shiya-liu/claude-code-my-workflow/explorations/pomodoro-enclosure/README.md

# 番茄钟外壳 v2 · Slab

用于 Waveshare **ESP32-S3-Touch-LCD-3.5B** 的 3D 打印桌面外壳。
一块薄的圆角屏幕板（整块玻璃外露，外壳圆角和玻璃的 R6 圆角同心），以 15° 斜插在一个矮底座里。
电池、喇叭和线都藏在底座里。整台设备唯一的颜色是红色 PWR 键。

- 屏幕板：68 × 99.4 × 15 mm
- 底座：76 × 58 × 26 mm
- 整体高度约 111 mm

尺寸来自 Waveshare 官方尺寸图：玻璃 92.44 × 61.00（R6），显示区 73.44 × 48.96，总厚 11.50，
M2 铜柱孔距 72.00 × 48.50，按键间距 11.00 / 8.50 / 8.50。板子竖装，USB-C 朝下。

## 打印文件（`out/`）

文件已经按打印方向摆好，导入切片软件后**不需要旋转**。全部零件用**哑光黑 PLA**（PWR 键可选红色，没有红色就用黑色）。

| 文件 | 数量 | 说明 |
|---|---|---|
| `1_shell.stl` 屏幕板外框 | 1 | 正面贴床；最好用纹理 PEI 板，层高 0.12–0.16 |
| `2_foot.stl` 底座 | 1 | 顶面贴床（已倒置） |
| `3_plate.stl` 底板 | 1 | |
| `4_cover.stl` 背盖 | 1 | |
| `5_buttons.stl` 按键帽 | 1 套（2 个） | 法兰贴床；很小，建议和其他零件一起打 |

`out/print_bed.png` 是全部零件摆在一块 250 × 220 打印板上的示意（Prusa CORE One+ 一次能打完）。

用 PrusaSlicer 按下面的设置实际切片估算（CORE One+ 用速度相近的 MK4 Input Shaper 配置代替，属于偏保守的估计）：

| 打印机 | 5 个零件一起打 | 最长的单件（底座） | 耗材 |
|---|---|---|---|
| CORE One+（限时 4 小时） | 约 2 小时 10 分 | 约 1 小时 05 分 | 约 70 g |
| MINI+（限时 10 小时，180 × 180） | 约 5 小时 15 分 | 约 2 小时 35 分 | 约 70 g |

最大的零件 99 × 76 mm，两台打印机的尺寸都放得下。屏幕板外框改用 0.15 层高会多出约 7 分钟。

0.4 喷嘴，层高 0.2，3 圈墙，15% 填充，**不需要支撑**，不需要 brim。按这个设置约用 70 g PLA。

## 购物清单（淘宝 / 京东 / 拼多多搜索关键词）

| 零件 | 搜索关键词 | 说明 |
|---|---|---|
| 哑光黑 PLA 1kg | `哑光黑 PLA 1.75mm` | 拓竹、易生 eSUN、天瑞等都有 |
| 红色 PLA（少量） | `红色 PLA 1.75mm` 或买样品卷 | 只打一个按键帽，也可以黑色打印后涂红漆 |
| 锂电池 | `3.7V 聚合物锂电池 103450 MX1.25` | 单节，插头 MX1.25 两针；电池仓 62 × 46 × 11 mm |
| 90° 弯头 USB-C 充电线 | `Type-C 90度弯头 充电线` | 普通弯头线即可（线沿板子底边横着走的「侧弯」款也行），1 m 左右；线从底座背面的槽穿出，直接插充电头 |
| M2 沉头螺丝 × 4 | `M2x5 沉头 十字 机牙螺丝` | 背盖固定到板子背面的铜柱 |
| M2 沉头自攻螺丝 × 4 | `M2x6 沉头 自攻螺丝` | 底板固定到底座 |
| 硅胶脚垫 × 4 | `自粘 硅胶脚垫 10mm` | |
| 双面泡棉胶 | `双面泡棉胶 3M` | 固定电池和喇叭 |
| 小喇叭 | 先看板子包装里有没有；没有就搜 `8Ω 1W 小喇叭 MX1.25` | 买前对照板子上 SPK 插座的规格 |

### 在美国采购（Amazon 搜索关键词）

| 零件 | 搜索关键词 | 说明 |
|---|---|---|
| 哑光 PLA | `Polymaker Matte PLA` / `Bambu Lab PLA Matte` / `Elegoo Matte PLA` | 黑色选 Charcoal Black，白色选 Cotton White / Ivory White |
| 锂电池 | `3.7V lipo battery MX1.25 2 pin` | ⚠️ Adafruit 等美国常见锂电池多为 **JST-PH 2.0** 插头，插不进 MX1.25；需要买 MX1.25 的，或另买 `MX1.25 to JST PH adapter` |
| 90° 弯头 USB-C 充电线 | `USB C right angle charging cable` | 普通弯头线即可，1 m 左右 |
| M2 沉头螺丝 | `M2 flat head countersunk machine screw assortment` | 用 M2×5；精确规格也可在 McMaster-Carr 买 |
| M2 沉头自攻螺丝 | `M2 countersunk self tapping screws` | 用 M2×6 |
| 脚垫 | `self adhesive silicone bumper feet 10mm` | |
| 双面泡棉胶 | `3M double sided foam mounting tape` | |
| 小喇叭 | `8 ohm 1W mini speaker MX1.25` | 先看板子包装里有没有 |

美国在线打印服务：Craftcloud、JLC3DP（寄美国）、Xometry。

不想自己打印：把 STL 上传到嘉立创 3D 打印等在线服务，选黑色树脂或黑色尼龙。

## 组装顺序

1. 两个按键帽从屏幕板外框里面插进右侧两个圆孔（法兰在里面）。
2. 弯头 USB-C 插到板子底边的 USB-C 口（线朝左或朝右都可以），弯头会从屏幕板底部的开口露出一点，这是正常的。
3. 板子正面朝前放进外框，USB 口朝下、按键一侧朝右。
4. 盖上背盖，用 4 颗 M2×5 沉头螺丝拧进板子的 4 个铜柱。背盖两侧有摩擦筋，是压紧的；
   觉得松可以在边缘点几点热熔胶（以后还能剥掉）。USB 线和电池线从背盖底部的缺口出来。
5. 电池、喇叭放进底座的仓里（泡棉胶固定），喇叭对着背面的小孔。
6. 屏幕板插进底座斜槽：弯头落进斜槽下方的凹槽，充电线顺着电池仓走到背面，从背面底部的开口槽放出去（装底板前放进去，底板会把它压住）。接好电池线和喇叭线。
7. 装底板（4 颗 M2×6 自攻螺丝），贴脚垫。

## 注意

- **插电池前先对照板子上的 + 号核对红线**，不同商家 MX1.25 的线序可能相反。
- 板子竖装、USB 朝下，程序里的屏幕方向要设成对应的方向。
- **SD 卡槽的位置是从产品照片估算的**，打印前请量一下它离玻璃底边的距离，改 `sd_z`。
- 建议先打印屏幕板外框（`shell.stl`）试装，确认合适后再打其他件。
- 所有尺寸都在 `pomodoro_enclosure.scad` 顶部，可用 OpenSCAD 修改后重新导出：
  `openscad -D 'part="shell"' -o out/shell.stl pomodoro_enclosure.scad`
- v1（梯形斜角座）在 git 历史里，提交 `37cfcff`。
