shiya-liu/claude-code-my-workflow/explorations/pomodoro-enclosure/out/cmp_black_back.png

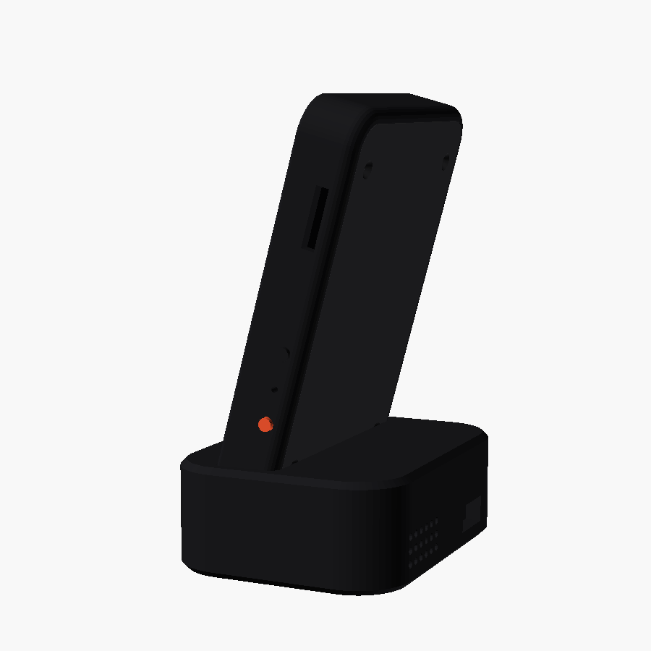
explorations/pomodoro-enclosure/out/cmp_black_back.png
