shiya-liu/claude-code-my-workflow/explorations/pomodoro-enclosure/out/cmp_black_front.png

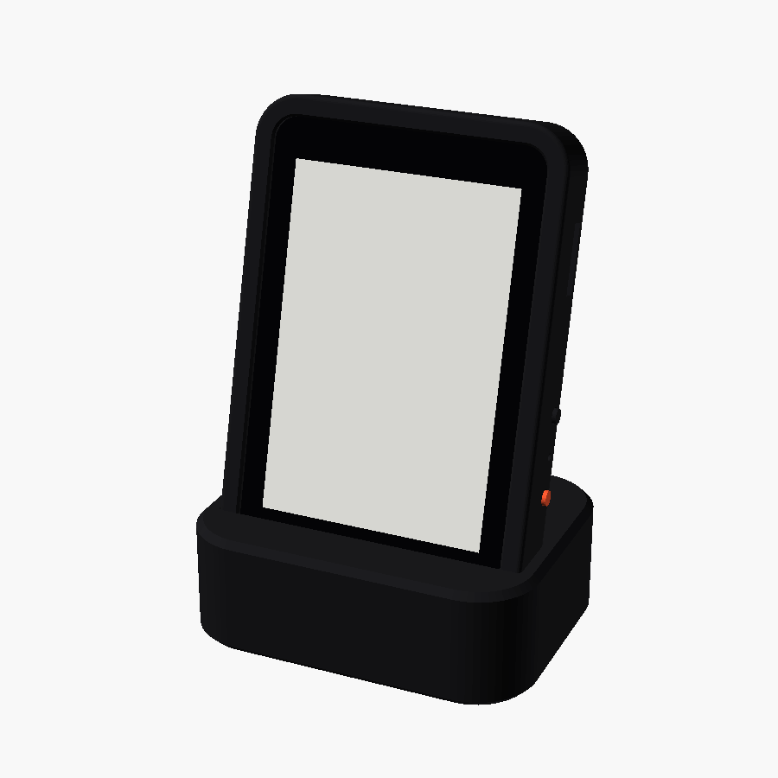
explorations/pomodoro-enclosure/out/cmp_black_front.png
