shiya-liu/claude-code-my-workflow/explorations/pomodoro-enclosure/out/cmp_white_front.png

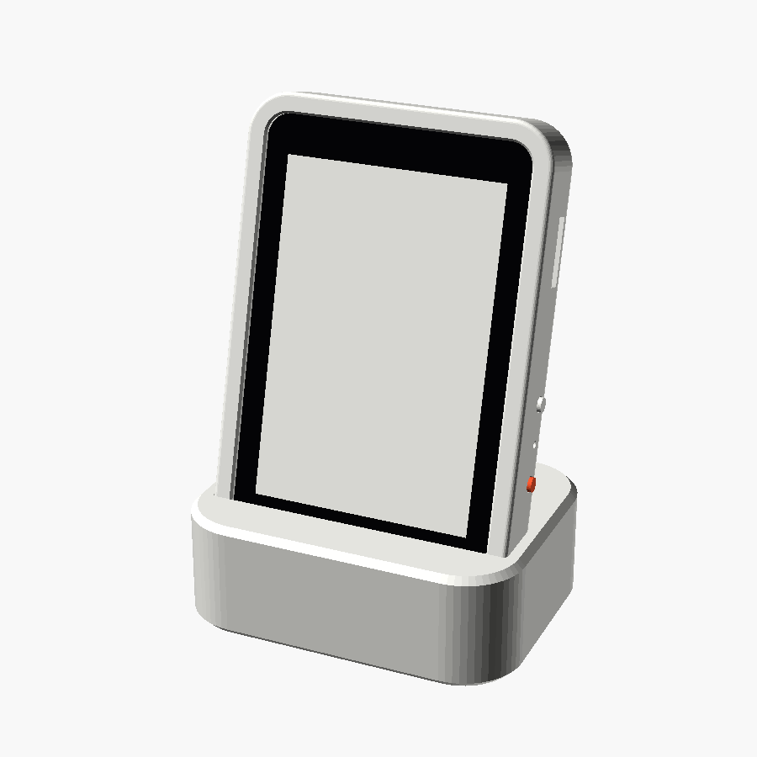
explorations/pomodoro-enclosure/out/cmp_white_front.png
