shiya-liu/claude-code-my-workflow/explorations/pomodoro-enclosure/out/compare_black_white.png

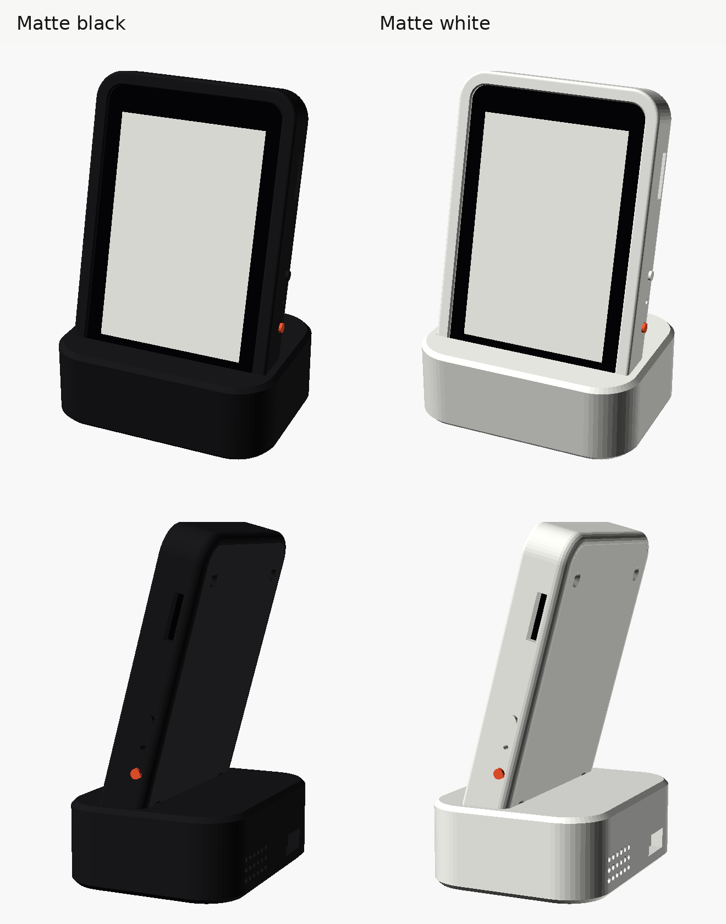
explorations/pomodoro-enclosure/out/compare_black_white.png
