shiya-liu/claude-code-my-workflow/explorations/pomodoro-enclosure/out/cutaway.png

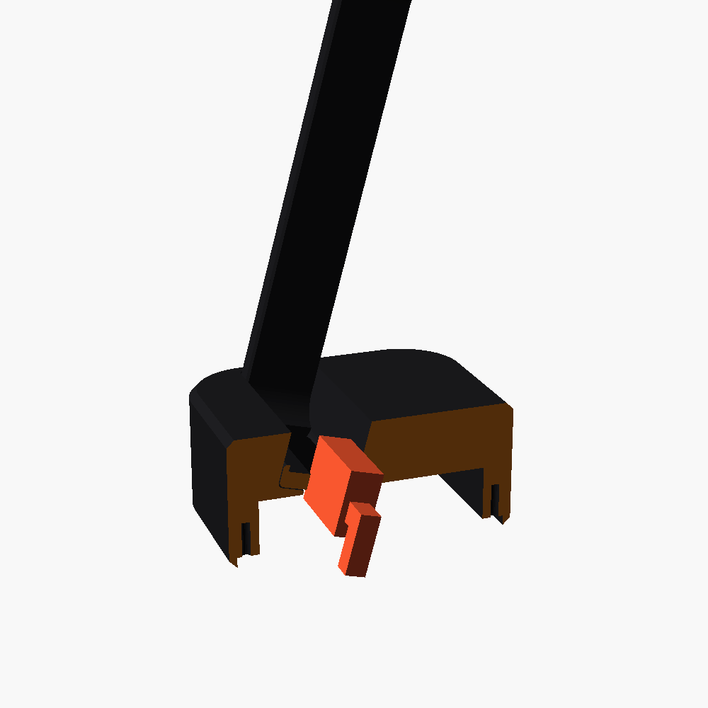
explorations/pomodoro-enclosure/out/cutaway.png
