shiya-liu/claude-code-my-workflow/explorations/pomodoro-enclosure/out/view_exploded.png

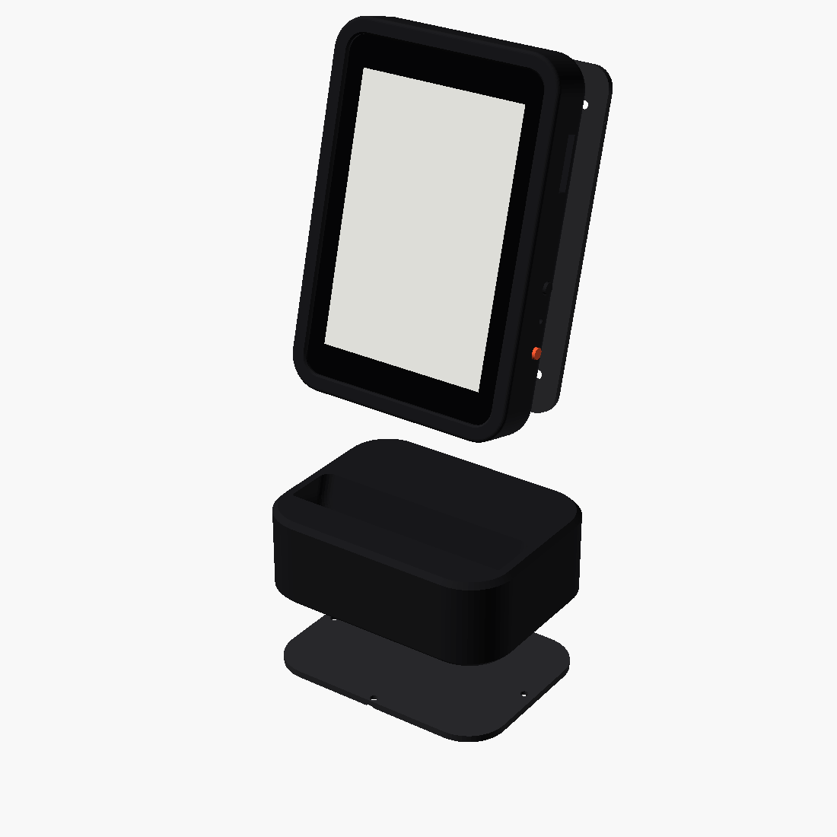
explorations/pomodoro-enclosure/out/view_exploded.png
