shiya-liu/claude-code-my-workflow/explorations/pomodoro-enclosure/out/4_cover.stl

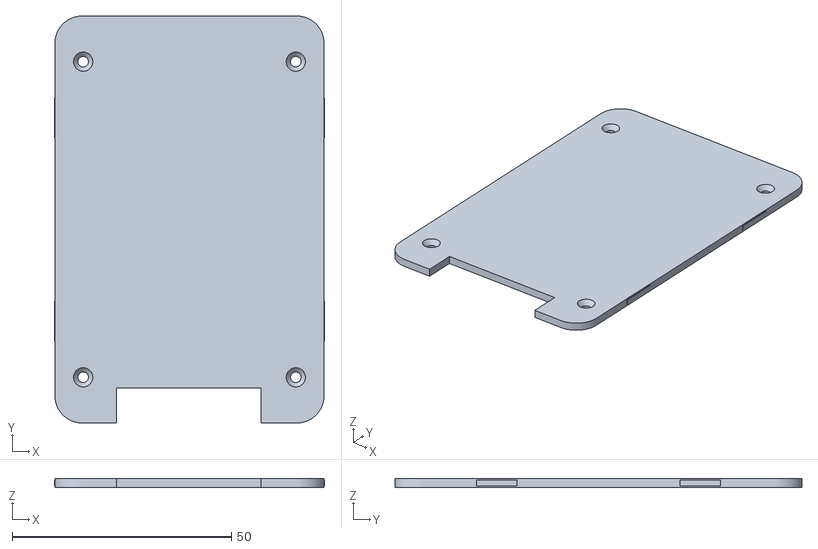
[picture p7: CAD file, 2026-09-27]
explorations/pomodoro-enclosure/out/4_cover.stl
61.7 x 92.8 x 2.00
