shiya-liu/claude-code-my-workflow/explorations/pomodoro-enclosure/out/2_foot.stl

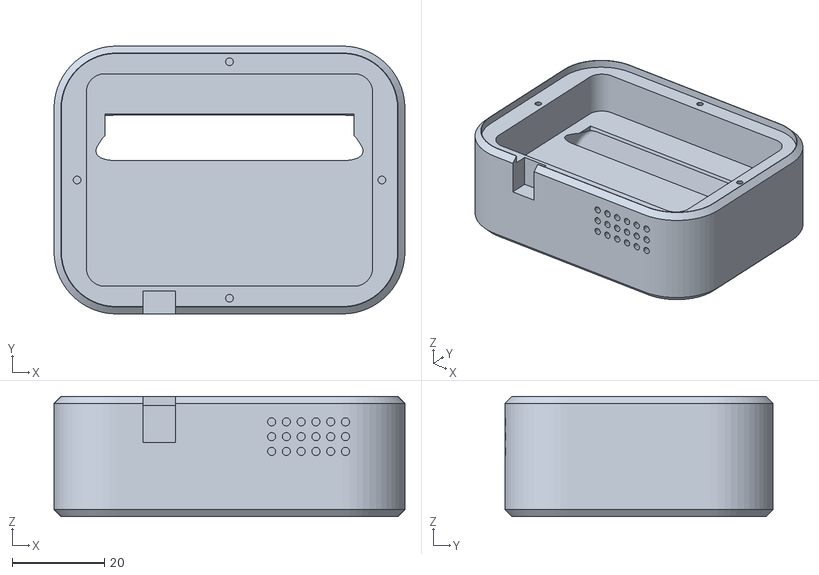
[picture p8: CAD file, 2026-09-27]
explorations/pomodoro-enclosure/out/2_foot.stl
76.0 x 58.0 x 26.0
