shiya-liu/claude-code-my-workflow/explorations/pomodoro-enclosure/out/1_shell.stl

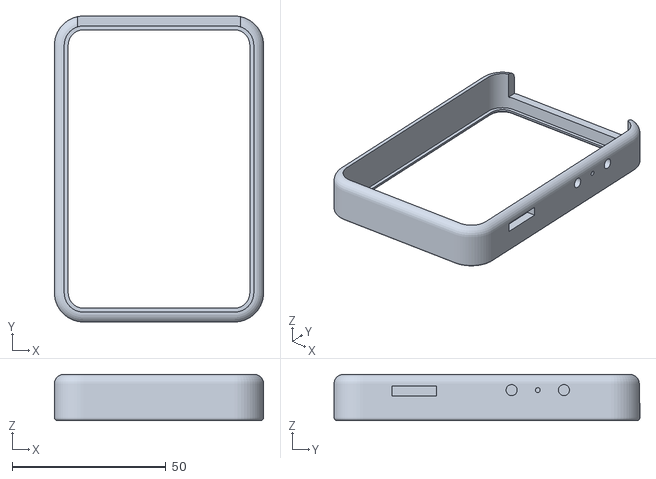
[picture p9: CAD file, 2026-09-27]
explorations/pomodoro-enclosure/out/1_shell.stl
68.0 x 99.4 x 15.0
