shiya-liu/claude-code-my-workflow/explorations/pomodoro-enclosure/out/5_buttons.stl

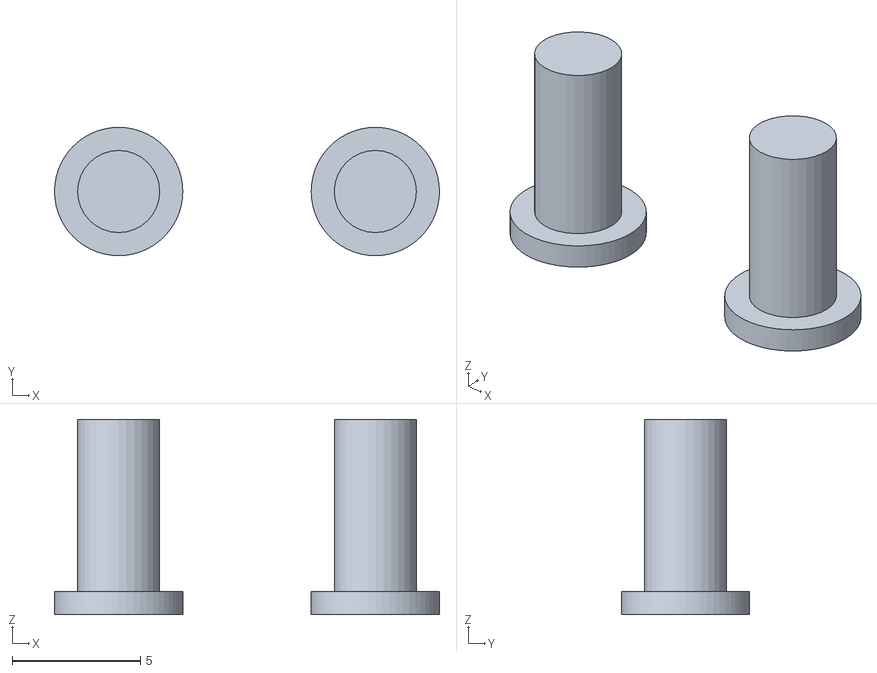
[picture p10: CAD file, 2026-09-26]
explorations/pomodoro-enclosure/out/5_buttons.stl
15.0 x 5.00 x 7.60
