shiya-liu/claude-code-my-workflow/explorations/pomodoro-enclosure/out/3_plate.stl

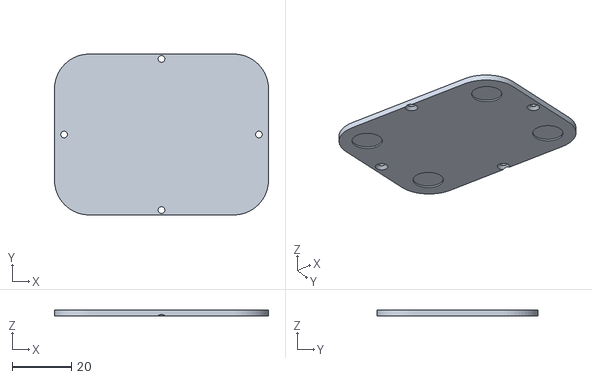
[picture p11: CAD file, 2026-09-26]
explorations/pomodoro-enclosure/out/3_plate.stl
72.5 x 54.5 x 2.00
