shiya-liu/claude-code-my-workflow/explorations/pomodoro-enclosure/out/cover.stl

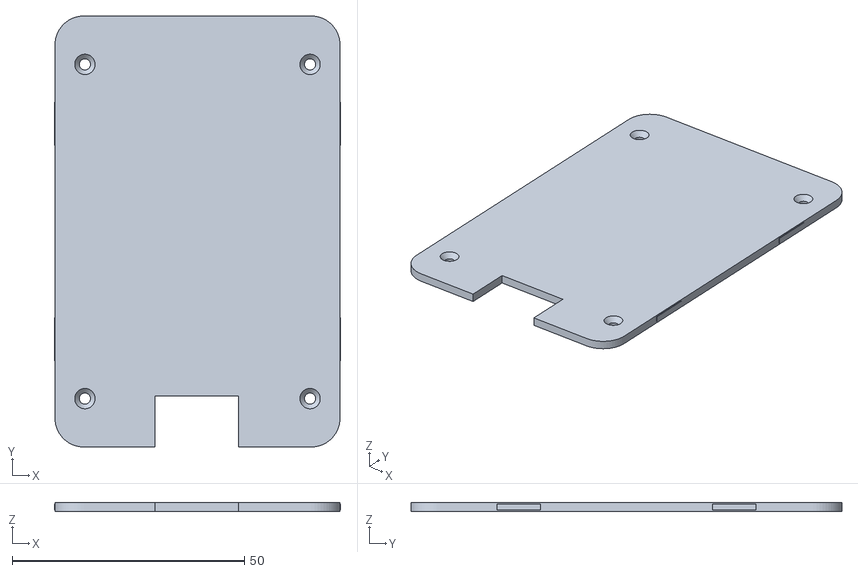
[picture p12: CAD file, 2026-09-26]
explorations/pomodoro-enclosure/out/cover.stl
61.7 x 92.8 x 2.00
