shiya-liu/claude-code-my-workflow/(list of files, cad)

Other CAD files:
explorations/pomodoro-enclosure/out/plate.stl
