shiya-liu/claude-code-my-workflow/explorations/pomodoro-enclosure/out/print_bed.png

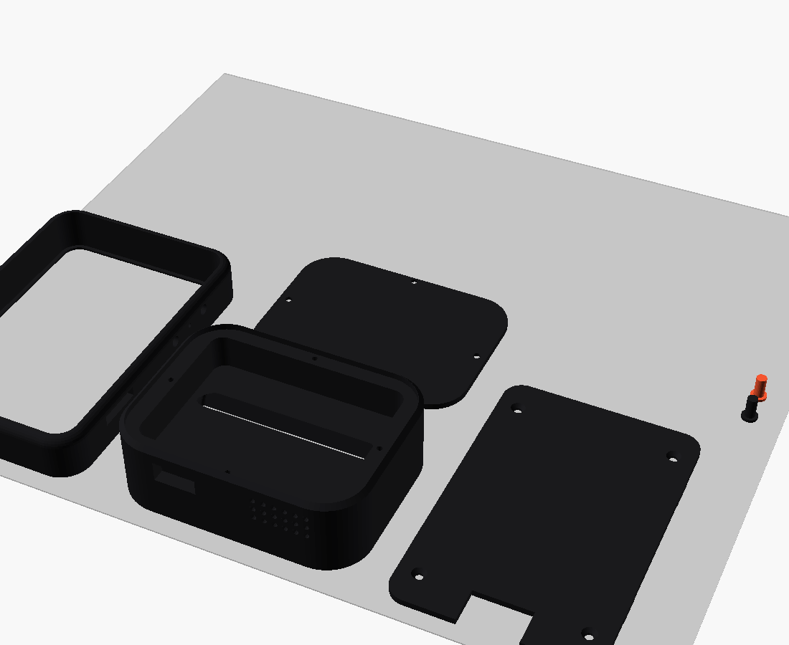
explorations/pomodoro-enclosure/out/print_bed.png
