shiya-liu/claude-code-my-workflow/(commit log)

2026-09-26 Add draft parametric enclosure for Pomodoro desk device
    OpenSCAD model (tilted desk wedge, flush bezel, battery bay, button caps)
    for the Waveshare ESP32-S3-Touch-LCD-3.5B. Board and port dimensions are
    placeholders marked [MEASURE]; not yet ready to print.
    Claude-Session: https://claude.ai/code/session_01GgLMMXwvBeRMnbvBHrX144
    [pomodoro_enclosure.scad]
2026-09-26 Enclosure v1 on official board dimensions: STLs, renders, build guide
    Rebuild the desk-wedge enclosure from Waveshare's drawings (92.44x61 glass,
    11.5 depth, M2 standoffs 72x48.5, button pitch 11/8.5/8.5). Adds a carrier
    plate screwed to the standoffs, 90-degree USB-C routing to a rear port,
    PWR/BOOT caps, RESET pinhole, microSD slot, battery bay and floor grille.
    Fixes the base block covering the tilted face.
    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
    [bezel.stl, body.stl, buttons.stl, carrier.stl, pomodoro_enclosure.scad]
2026-09-26 Enclosure v2 "Slab": thin rounded screen slab in a low foot
    Replace the trapezoid wedge with a 15 mm slab (corners concentric with
    the glass R6, whole glass visible) that sits at 15 degrees in a foot
    holding the battery, speaker and cables. Parts: shell, cover (screwed to
    the board standoffs), foot, bottom plate, button caps. Adds a shopping
    list to the build guide.
    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
    [bezel.stl, body.stl, buttons.stl, carrier.stl, cover.stl, foot.stl, plate.stl, pomodoro_enclosure.scad]
2026-09-26 Add black/white colour comparison and US shopping list
    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
    [pomodoro_enclosure.scad]
2026-09-26 Add per-part colours and two-tone renders
    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
    [pomodoro_enclosure.scad]
2026-09-26 Print-ready STLs for all-black build
    Export each part already oriented for the bed (shell face-down, foot
    upside-down), number the files, move the button flange to the inner end
    so caps print flange-down, add a one-bed layout render for a 250x220 printer.
    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
    [1_shell.stl, 2_foot.stl, 3_plate.stl, 4_cover.stl, 5_buttons.stl, buttons.stl, foot.stl, pomodoro_enclosure.scad]
2026-09-27 Enclosure: fit a sideways-bent 90° USB-C cable
    Open the slab bottom behind the front strip, add a pocket under the slab
    in the foot that joins the battery bay, widen the cover notch, and
    replace the rear panel-socket hole with a bottom-open cable slot. Fit
    checks with a plug model (18 x 13 x 7 mm) pass in both orientations.
    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
    [1_shell.stl, 2_foot.stl, 4_cover.stl, pomodoro_enclosure.scad]
2026-09-29 Enclosure README: sliced print times for CORE One+ and MINI+
    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
